Rich5252/Arduino_ESP32_AD9851_ssb_signal_generator_exciter/digi_gaussian_spread.png

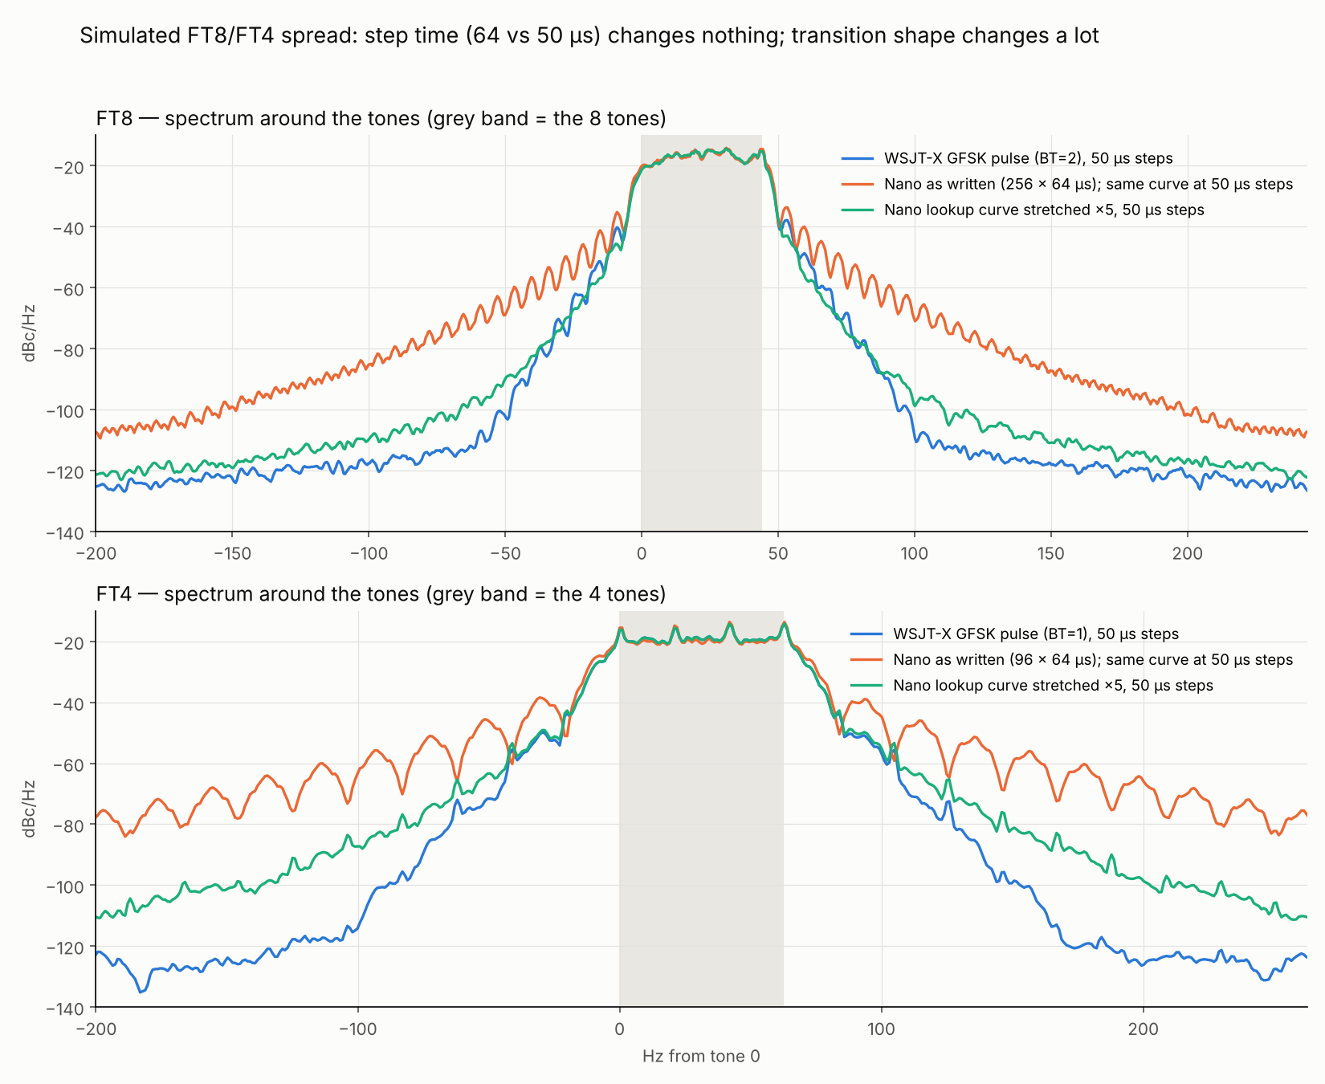
digi_gaussian_spread.png
