Rich5252/Arduino_ESP32_AD9851_ssb_signal_generator_exciter/PerformamnceMeasurements/digi_generator_spectrum.png

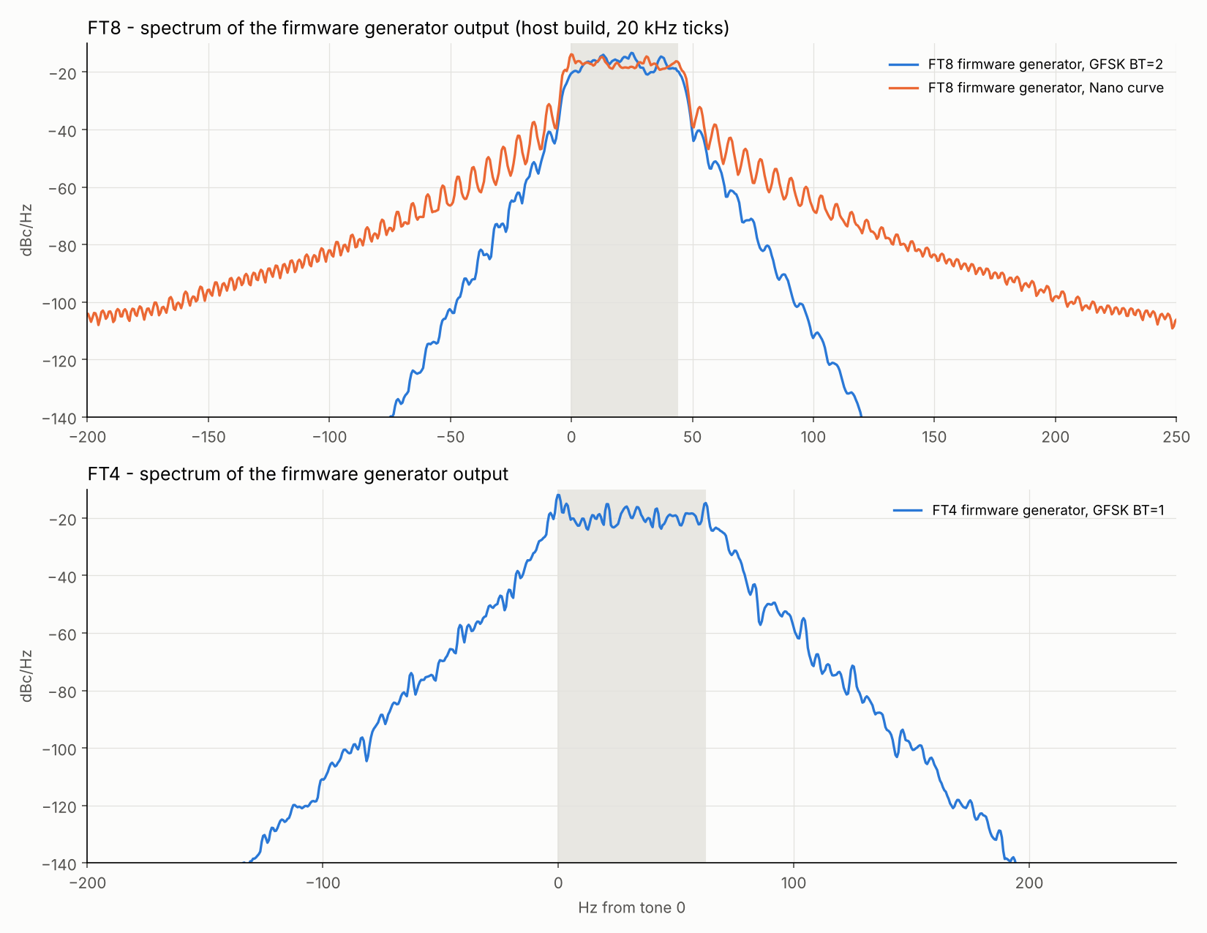
PerformamnceMeasurements/digi_generator_spectrum.png
