Rich5252/Arduino_ESP32_AD9851_ssb_signal_generator_exciter/rtty_shaping_spectrum.png

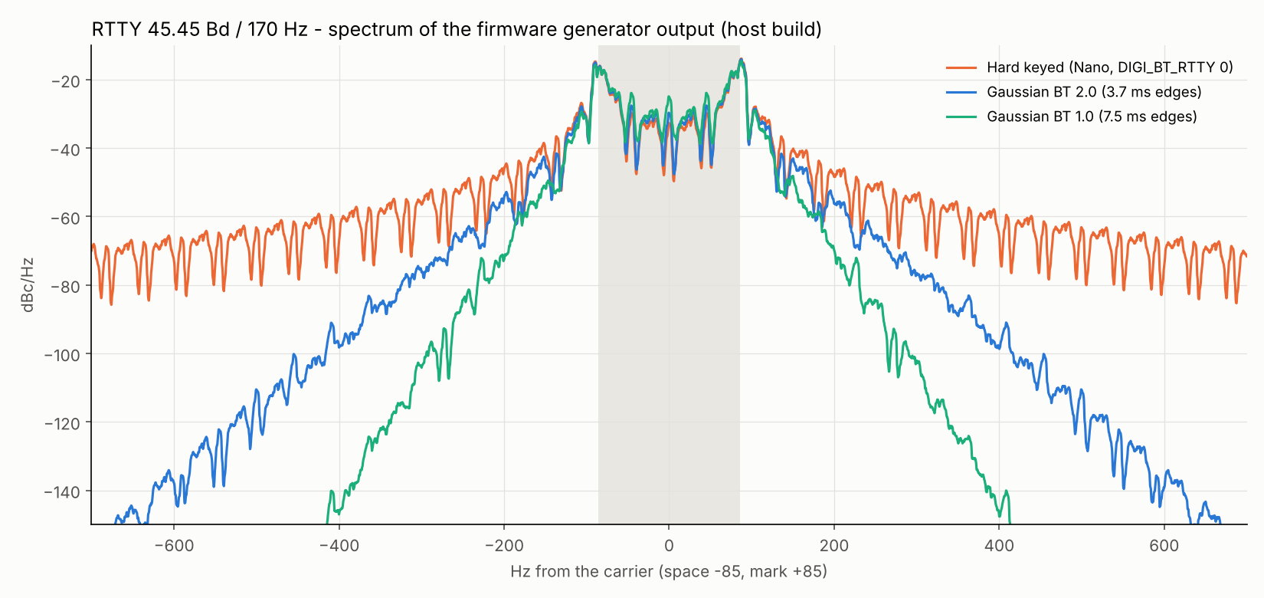
rtty_shaping_spectrum.png
