Rich5252/Arduino_ESP32_AD9851_ssb_signal_generator_exciter/digi_gen.cpp

/**
 * digi_gen.cpp - see digi_gen.h. Port of the TXlink Nano digital modes (TXlink4_Nano_Latest d3db0ad):
 * TXlink4_Nano.ino (DigitalTXmsg, AdjustStart, set_digital_tx_buffer, setDigDefaults, the {V}{W}{X}{Y}{Z} commands),
 * RTTY.ino, rtty_queue.ino, JTTY.ino. Lines marked "Nano:" follow the Nano code; "ESP32:" marks a deliberate change.
 */

#include "digi_gen.h"
#include <string.h>
#include <math.h>

// Tick path placement (2026-11-12). On the ESP32 everything dsp_task calls must run from internal RAM (IRAM): code
// in flash stalls whenever Core 1 activity has pushed it out of the shared cache (ssb_mic_test.ino, above
// dsp_task). Bench 2026-11-12 with this module in flash: max_busy 61 us, 3 overruns (CW alone: 44 us). DIGI_HOT puts
// a function in IRAM, DIGI_DATA puts constant tables the tick reads in DRAM. Nothing on a host build.
#if defined(ESP_PLATFORM) || defined(ARDUINO_ARCH_ESP32)
#include "esp_attr.h"
#define DIGI_HOT  IRAM_ATTR
#define DIGI_DATA DRAM_ATTR
#else
#define DIGI_HOT
#define DIGI_DATA
#endif

#define fence_release() __atomic_thread_fence(__ATOMIC_RELEASE)
#define fence_acquire() __atomic_thread_fence(__ATOMIC_ACQUIRE)

// ======================================================================================================== constants
// Nano: tone spacing / duration / symbol count per mode. ESP32: spacing in exact Hz (the Nano used FTW increments
// worth 6.2499 / 20.8332 / 41.6664 / 31.2498 Hz).
#define FT8_TONE_SPACING_HZ    6.25f
#define FT8_tone_duration      160
#define FT8_SYMBOL_COUNT       79
#define FT4_TONE_SPACING_HZ    (12000.0f / 576.0f)   // 20.8333
#define FT4_tone_duration      48
#define FT4_SYMBOL_COUNT       105
#define FT2_TONE_SPACING_HZ    (12000.0f / 288.0f)   // 41.6667
#define FT2_tone_duration      24
#define FT2_SYMBOL_COUNT       105
#define JTTY_TONE_SPACING_HZ   31.25f
#define JTTY_tone_duration     32

// Nano: "ERROR G4AHN" symbol lists, used when a {Z} list does not match the mode's symbol count
#define FT8TxMsgErr "3140652000026673266772757272250010533140652177703660737035675174622021543140652"

// Nano RTTY.ino
#define RTTY_BAUD              45.45
static const long BIT_DURATION_US      = (long)(1000000.0 / RTTY_BAUD + 0.5);   // 22002 us
static const long STOP_BIT_DURATION_US = (long)(BIT_DURATION_US * 2 + 0.5);     // 44004 us (Nano comment says 1.5)
#define MARK_FREQ   (170 / 2)
#define SPACE_FREQ  (-170 / 2)
static const int LETTERS_SHIFT_CODE = 31, FIGURES_SHIFT_CODE = 27, CR_CODE = 8, LF_CODE = 2, SPACE_CODE = 4, NULL_CODE = 0;

// Nano rtty_queue.h
#define MAX_QUEUE_MESSAGES 4
#define MAX_MESSAGE_LENGTH 72

// Nano JTTY.h
#define JTTY_SYNC_LEN      13
#define JTTY_DATA_LEN      46
#define JTTY_FRAME_LEN     (JTTY_SYNC_LEN + JTTY_DATA_LEN)   // 59
#define JTTY_MAX_FRAMES    16
#define JTTY_MAX_DATA      (JTTY_MAX_FRAMES * JTTY_DATA_LEN)  // 736 symbols
#define JTTY_BUF_BYTES     (JTTY_MAX_DATA / 4)                // 184 bytes
static const uint8_t DIGI_DATA jttySync[JTTY_SYNC_LEN] = {0,2,2,3,0,0,3,2,1,3,1,2,0};   // Nano: from WSJT-X jtty_fec_mod.f90

// Nano Gaussian_G_Scaled[] (TXlink4_Nano.ino), used only by shape 0
static const uint16_t Gaussian_G_Scaled[33] = {
    0, 518, 705, 948, 1264, 1667, 2177, 2815, 3602,
    4565, 5726, 7110, 8741, 10638, 12817, 15288, 18052,
    21102, 24421, 27978, 31732, 35630, 39604, 43582, 47477,
    51203, 54668, 57782, 60461, 62631, 64228, 65206, 65535
};

// ============================================================================================ transition table
// phi[x + W], x = ticks from a symbol boundary in -W..W: fraction of the tone change done (0 before, 1 after).
#define DIGI_MAX_W 1100
typedef struct {
    int   mode;
    int   W;                 // half width, ticks
    int   nsym;              // ticks per symbol (FT/JTTY)
    float spacing_hz;
    int   symbol_count;      // FT modes
    int   tone_duration_ms;
    float phi[2 * DIGI_MAX_W + 1];
} digi_tab_t;
static digi_tab_t s_tab[2];
static volatile int s_tab_pub = 0;

static digi_cfg_t s_cfg = { 20000, 1, 2.0f, 1.0f, 1.0f, 2.0f, 0.0f };
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
