Rich5252/Arduino_ESP32_AD9851_ssb_signal_generator_exciter/(commit log)

2026-10-03 BEST SO FAR. Changed to 20kHz Fs with 40kHz ADC, x2 ISR Interp. Hilbert dsp speed upgrade so we can run 129 taps - needed to suppress 400Hz image.
2026-10-04 Reset two tone gen when type changed. Tweek settings for 20kFs. Change Micr HPF to 350Hz to try and help with image break through.
    [serial_commands.cpp, settings.h, ssb_dsp.c, ssb_dsp.h, ssb_mic_test.ino, test_signals.cpp, test_signals.h]
2026-10-04 Change ADC audio level reading to reject DC level.
2026-10-12 Add {F14200000} command to set Freq. Also {C12345} cmd to set calibration using correct method in AD9851.h. Default should map the 160Hz correction we had at 14.2MHz.
2026-11-04 Notes for new thread that is looking at TXlink integration/porting issues.
2026-11-05 Add nonblocking low-speed ADC support
    Spread ADC2 conversions across task wake-ups to avoid blocking DSP, while retaining driver-read mode as an option. Add averaged channel reporting and `{K}` timing and DSP health counters. Make MCP4725 code conditional so GPIO47/48 can be used for TXlink signals. Update command documentation and bench notes.
2026-11-05 Move all ESP32 pin allocations to new ESP32_hardware.h
2026-11-05 Add Tx pin and new code files to echo the {F...} -> {f...} cmd to the Tx pin for filters/atu
2026-11-06 Add {U} & {D} commands that switch TXout gpio that switches on local PA and Ant relay.
2026-11-10 New hardware installed with new pin assignments.
2026-11-10 Add USB/LSB and two tone modes (M32, 64, 128). Working on a 10ms loop currently. TX via Micr PTT switch.
2026-11-11 Rescale SWR inputs, tighten up trip on SWR to check REV overload. Trip now happens directly in ESP32. Add {Tn} temp limit and trip logic incl. error condx checks.
2026-11-11 Tidy up all devlopment serial output so it is disabled on boot. Also disable ack responses from {} commands for future development of the SDR plugin.
    Add PA out and Fan control together with {Q} & {R} setup cmds.
2026-11-12 Move digital tick path into IRAM
    Place tick-path code and data in IRAM/DRAM on ESP32. Use integer-microsecond RTTY timing and 32-bit tick conversion. Host checks pass; ESP32 build and timing remeasurement remain pending.
2026-11-12 Chasing stale dsp sample values. Move diags code.
2026-11-12 Change tx trip on failed sensor to x3 readings to avoid the odd adc zero output.
2026-11-12 Timing profiler for stale dsp tick samples
2026-11-12 No code change. Document: CARRIER_MODES_SKIP_DSP LEGACY_TICK_DIAGS_ENABLED SSB_DSP_DIAG_ENABLED TICK_PROFILE_ENABLED STAGE_LATENCY_DIAG_ENABLED
